VatsalSheth/Smart-Energy-Monitor/Bhishma_Slave.xlsx

Mouser Part Number | Description | Designator | Manufacturer_Part_Number | Quantity | Value | Mouser Price/Stock
81-GCM188R71C105K64D | Capacitor | C31, C111, C115, C116, C118, C209, C215 | GCM188R71C105KA64D | 7 | 1uF | https://www.mouser.com/Search/Refine.aspx?Keyword=81-GCM188R71C105K64D
81-GRM188C71E225KE1J | Capacitor | C32 | GRM188C71E225KE11J | 1 | 2.2uF | https://www.mouser.com/Search/Refine.aspx?Keyword=81-GRM188C71E225KE1J
581-06036D226MAT2A | Capacitor | C33 | 06036D226MAT2A | 1 | 22u | https://www.mouser.com/Search/Refine.aspx?Keyword=581-06036D226MAT2A
 | Capacitor | C101 | GRM1885C1H1R5CA01D | 1 | 1.5pF
81-GCG1885G1H101JA1D | Capacitor | C102 | GCG1885G1H101JA01D | 1 | 100pF | https://www.mouser.com/Search/Refine.aspx?Keyword=81-GCG1885G1H101JA1D
81-GCG1885G1H100JA1D | Capacitor | C103, C108 | GCG1885G1H100JA01D | 2 | 10pF | https://www.mouser.com/Search/Refine.aspx?Keyword=81-GCG1885G1H100JA1D
81-GCM188R71E224K55D | Capacitor | C106 | GCM188R71E224KA55D | 1 | 220nF | https://www.mouser.com/Search/Refine.aspx?Keyword=81-GCM188R71E224K55D
581-0603YC104JAT4A | Capacitor | C107, C119, C147, C148, C203, C205, C207, C210, C213, C216, C217, C218, C219, C220, C221 | 0603YC104JAT4A | 15 | 100nF | https://www.mouser.com/Search/Refine.aspx?Keyword=581-0603YC104JAT4A
81-GRM188R61E106KA3D | Capacitor | C110, C123, C149 | GRM188R61E106KA73D | 3 | 10 uF, 10uF, 10uF | https://www.mouser.com/Search/Refine.aspx?Keyword=81-GRM188R61E106KA3D
81-GCM1887U1H103JA6J | Capacitor | C113, C222 | GCM1887U1H103JA16J | 2 | 10nF | https://www.mouser.com/Search/Refine.aspx?Keyword=81-GCM1887U1H103JA6J
80-C0603C150F5GACTU | Capacitor | C201, C202 | C0603C150F5GACTU | 2 | 15pF | https://www.mouser.com/Search/Refine.aspx?Keyword=80-C0603C150F5GACTU
80-C0603C151J4G | Capacitor | C204, C206, C208, C211, C214 | C0603C151J4GACTU | 5 | 150pF | https://www.mouser.com/Search/Refine.aspx?Keyword=80-C0603C151J4G
81-GRM188R61C475KAJD | Capacitor | C212 | GRM188R61C475KAAJD | 1 | 4.7uF | https://www.mouser.com/Search/Refine.aspx?Keyword=81-GRM188R61C475KAJD
81-GRM1887U1A223JA1D | Capacitor | C223 | GRM1887U1A223JA01D | 1 | 22nF | https://www.mouser.com/Search/Refine.aspx?Keyword=81-GRM1887U1A223JA1D
595-TPD1E10B06DPYT | Single-Channel ESD in 0402 Package With 10pF Capacitance and 6V Breakdown 2-X1SON -40 to 125 | D31 | TPD1E10B06DPYT | 1 | TPD1E10B06DPYT
634-BGP632F512GM48D | Integrated Circuit | IC1 | EFR32BG13P632F512GM48-D | 1 |  | https://www.mouser.com/Search/Refine.aspx?Keyword=634-BGP632F512GM48D
584-LTC3550EDHC#PBF | Integrated Circuit | IC3 | LTC3550EDHC#PBF | 1 | LTC3550 | https://www.mouser.com/Search/Refine.aspx?Keyword=584-LTC3550EDHC%23PBF
511-STPM34TR | Integrated Circuit | IC5 | STPM34TR | 1 | STPM34TR | https://www.mouser.com/Search/Refine.aspx?Keyword=511-STPM34TR
512-FOD8012AR2 | Integrated Circuit | IC6 | FOD8012AR2 | 1 | FOD8012AR2 | https://www.mouser.com/Search/Refine.aspx?Keyword=512-FOD8012AR2
512-FOD8001 | Integrated Circuit | IC7, IC8 | FOD8001 | 2 | FOD8001 | https://www.mouser.com/Search/Refine.aspx?Keyword=512-FOD8001
490-UJ2-MIBH2-4-SMT | Micro B, USB 2.0, 1.8 A, Right Angle, Surface Mount _SMT_, USB Receptacle | J2 | UJ2-MIBH2-4-SMT-TR | 1 | UJ2-MIBH2-4-SMT-TR
710-691508110302 | 5081 Series 3.5mm Pitch Horizontal, PCBTerminal Block, Surface Mount, 2 Way | J3, J7, J8 | 691508110302 | 3
538-87898-1066 | Connector | J6, J103, J104, J105 | 87898-1066 | 3 |  | https://www.mouser.com/Search/Refine.aspx?Keyword=538-87898-0306
200-FTSH10501FDVK | Connector | J101 | FTSH-105-01-F-DV-K | 1 |  | https://www.mouser.com/Search/Refine.aspx?Keyword=200-FTSH10501FDVK
810-SLF6028T-4R7M | Inductor | L2 | SLF6028T-4R7M1R6-PF | 1 | 4.7uH | https://www.mouser.com/Search/Refine.aspx?Keyword=810-SLF6028T-4R7M
 | Inductor | L101, L102 | LQP03TQ1N9C02D | 2 | 1.9nH
810-KLZ1608MHR4R7WTD | Inductor | L103 | KLZ1608MHR4R7WTD25 | 1 | 4.7uH | https://www.mouser.com/Search/Refine.aspx?Keyword=810-KLZ1608MHR4R7WTD
81-BLM11A601S | Filter | L104, L105 | BLM18AG601SN1D | 2 |  | https://www.mouser.com/Search/Refine.aspx?Keyword=81-BLM11A601S
710-74279266 | Ferrite Bead | L106 | 74279266 | 1 | CBF102WB | https://www.mouser.com/Search/Refine.aspx?Keyword=710-74279266
630-HSMC-C190 | LED | LED2 | HSMC-C190 | 1 |  | https://www.mouser.com/Search/Refine.aspx?Keyword=630-HSMC-C190
798-U.FL-R-SMT-110 | Connector | P101 | U.FL-R-SMT-1(10) | 1 |  | https://www.mouser.com/Search/Refine.aspx?Keyword=798-U.FL-R-SMT-110
709-IRM03-3.3S | Power Supply | PS1 | IRM-03-3.3S | 1 | IRM-03-3.3S | https://www.mouser.com/Search/Refine.aspx?Keyword=709-IRM03-3.3S
594-MCT06030D2201BP1 | Resistor | R31, R34 | MCT06030D2201BP100 | 2 | 2.2K | https://www.mouser.com/Search/Refine.aspx?Keyword=594-MCT06030D2201BP1
667-ERA-3ARB112V | Resistor | R32 | ERA-3ARB112V | 1 | 1.1K | https://www.mouser.com/Search/Refine.aspx?Keyword=667-ERA-3ARB112V
594-MCT0603MD1001BP5 | Resistor | R33 | MCT0603MD1001BP500 | 1 | 1K | https://www.mouser.com/Search/Refine.aspx?Keyword=594-MCT0603MD1001BP5
71-TNPW12061M35BEEN | Res Thin Film 1206 1.35M Ohm 0.1% 0.25W_1/4W_ Â±25ppm/C Molded SMD Paper T/R | R35 | TNPW12061M35BEEN | 1 | 1.35M
667-ERA-3AEB3013V | Resistor | R36 | ERA-3AEB3013V | 1 | 301K | https://www.mouser.com/Search/Refine.aspx?Keyword=667-ERA-3AEB3013V
279-CRGS0603J1R0 | Resistor | R101 | CRGS0603J1R0 | 1 | 1 Ohm | https://www.mouser.com/Search/Refine.aspx?Keyword=279-CRGS0603J1R0
71-CRCW12060000Z0EAC | Resistor | R102, R104, R202 | CRCW12060000Z0EAC | 3 | 0R | https://www.mouser.com/Search/Refine.aspx?Keyword=71-CRCW12060000Z0EAC
594-MCT06030C1004FP5 | Resistor | R201 | MCT06030C1004FP500 | 1 | 1M | https://www.mouser.com/Search/Refine.aspx?Keyword=594-MCT06030C1004FP5
594-MCT0603MD1002BP5 | Resistor | R203, R204, R205, R206 | MCT0603MD1002BP500 | 4 | 10K | https://www.mouser.com/Search/Refine.aspx?Keyword=594-MCT0603MD1002BP5
594-MCT0603PD1001DP5 | Resistor | R207, R208 | MCT0603PD1001DP500 | 2 | 1K | https://www.mouser.com/Search/Refine.aspx?Keyword=594-MCT0603PD1001DP5
279-RP73D1J5R9BTDG | Resistor | R209 | RP73D1J5R9BTDG | 1 | 5R9 | https://www.mouser.com/ProductDetail/TE-Connectivity-Holsworthy/RP73D1J5R9BTDG
594-MCT06030C2703FP5 | Resistor | R210, R211, R212 | MCT06030C2703FP500 | 3 | 270K | https://www.mouser.com/Search/Refine.aspx?Keyword=594-MCT06030C2703FP5
667-ERA-3APB471V | Resistor | R213 | ERA-3APB471V | 1 | 470R | https://www.mouser.com/Search/Refine.aspx?Keyword=667-ERA-3APB471V
612-LL3301NF065QG | Switch | S101 | LL3301NF065QG | 1 |  | https://www.mouser.com/Search/Refine.aspx?Keyword=612-LL3301NF065QG
520-384-8-36Q-CKYT | Crystal or Oscillator | Y101 | ECS-384-8-36Q-CKY-TR | 1 | 38.4 MHz | https://www.mouser.com/ProductDetail/ECS/ECS-384-8-36Q-CKY-TR
520-.327-6-12R-T | Crystal or Oscillator | Y102 | ECS-.327-6-12R-TR | 1 | 32.768KHz | https://www.mouser.com/ProductDetail/ECS/ECS-327-6-12R-TR
520-160-8-36B-CKYT | Crystal or Oscillator | Y201 | ECS-160-8-36B-CKY-TR | 1 | 16MHz | https://www.mouser.com/Search/Refine.aspx?Keyword=520-160-8-36B-CKYT
5169-UBP563450 | Battery 3.7V 950 mAh |  | UBP002 | 2 | 3.7V 900mAh | https://www.mouser.com/ProductDetail/Ultralife/UBP002
