VatsalSheth/Smart-Energy-Monitor/Bhishma/BgBuild_Log.txt

// Copyright 2019 Silicon Laboratories, Inc.
//
//

Executing: bgbuild.exe (C:\SiliconLabs\SimplicityStudio\v4\developer\sdks\blemesh\v1.3\protocol\bluetooth\bin\bgbuild.exe)
Standard output
ALL OK
