VatsalSheth/Smart-Energy-Monitor/Bhishma_Slave.pdf

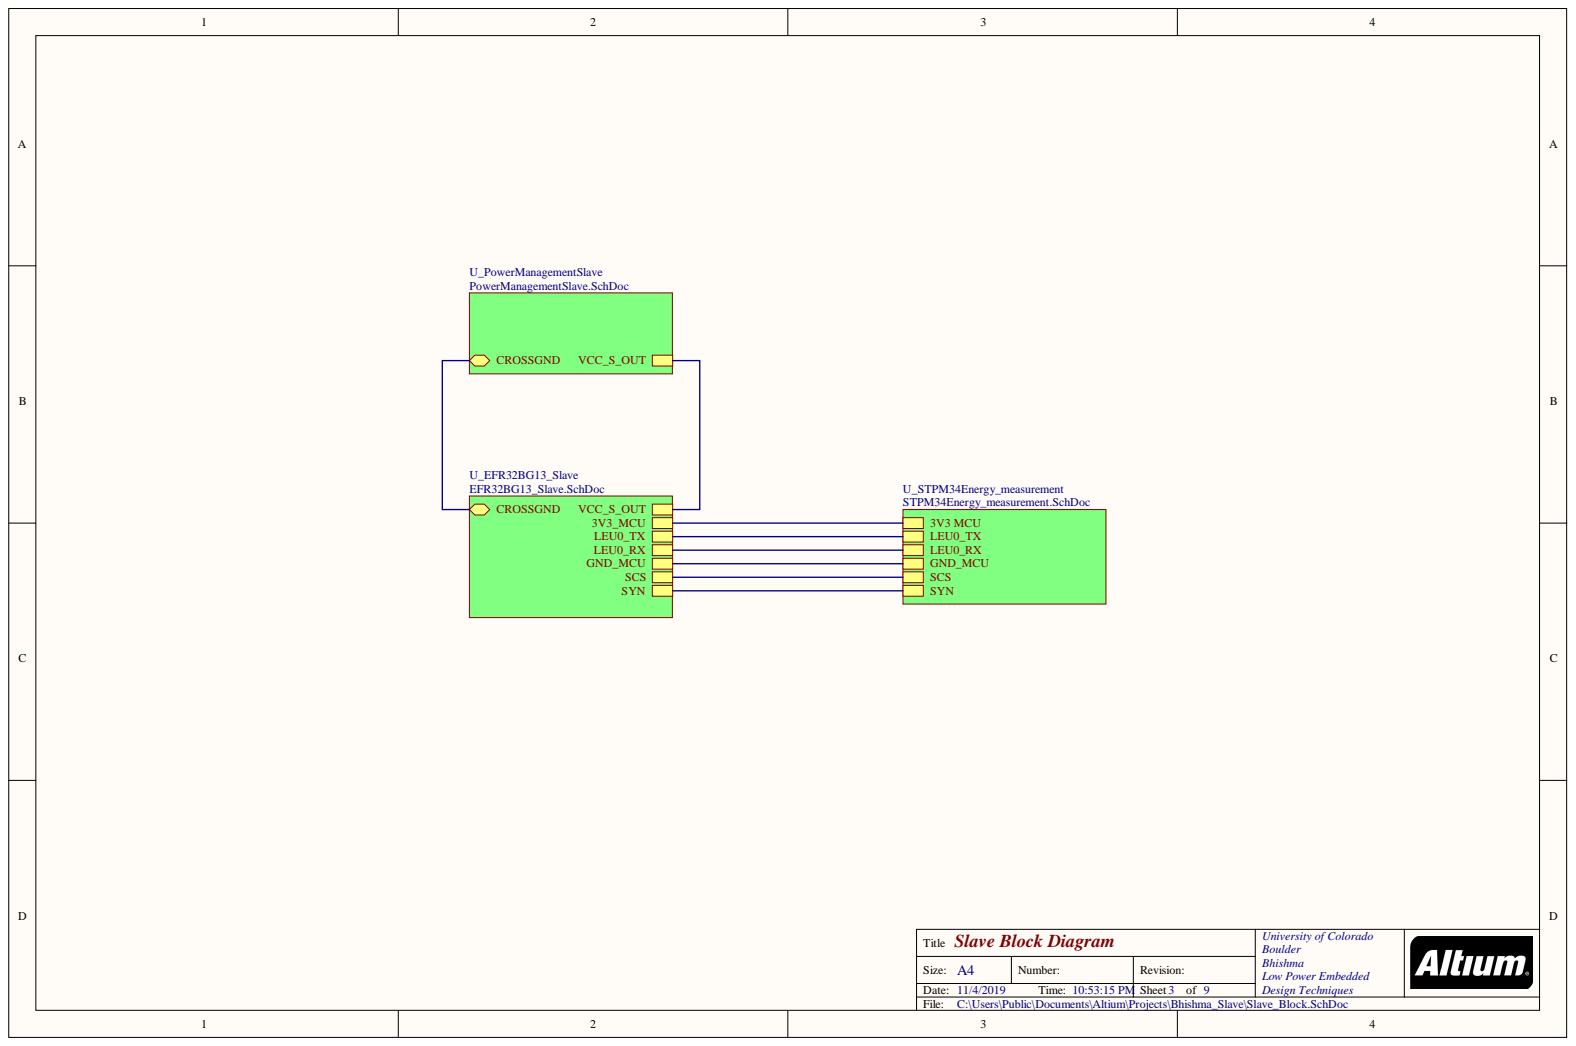
[picture p22: page 1]

Slave Block Diagram Title | University of Colorado Boulder Bhishma Low Power Embedded Design Techniques

A4 Size: | Number: | Revision:

Date: 11/4/2019 Time: 10:53:15 PM | | Sheet 3 of 9
File: C:\Users\Public\Documents\Altium\Projects\Bhishma_Slave\Slave_Block.SchDoc

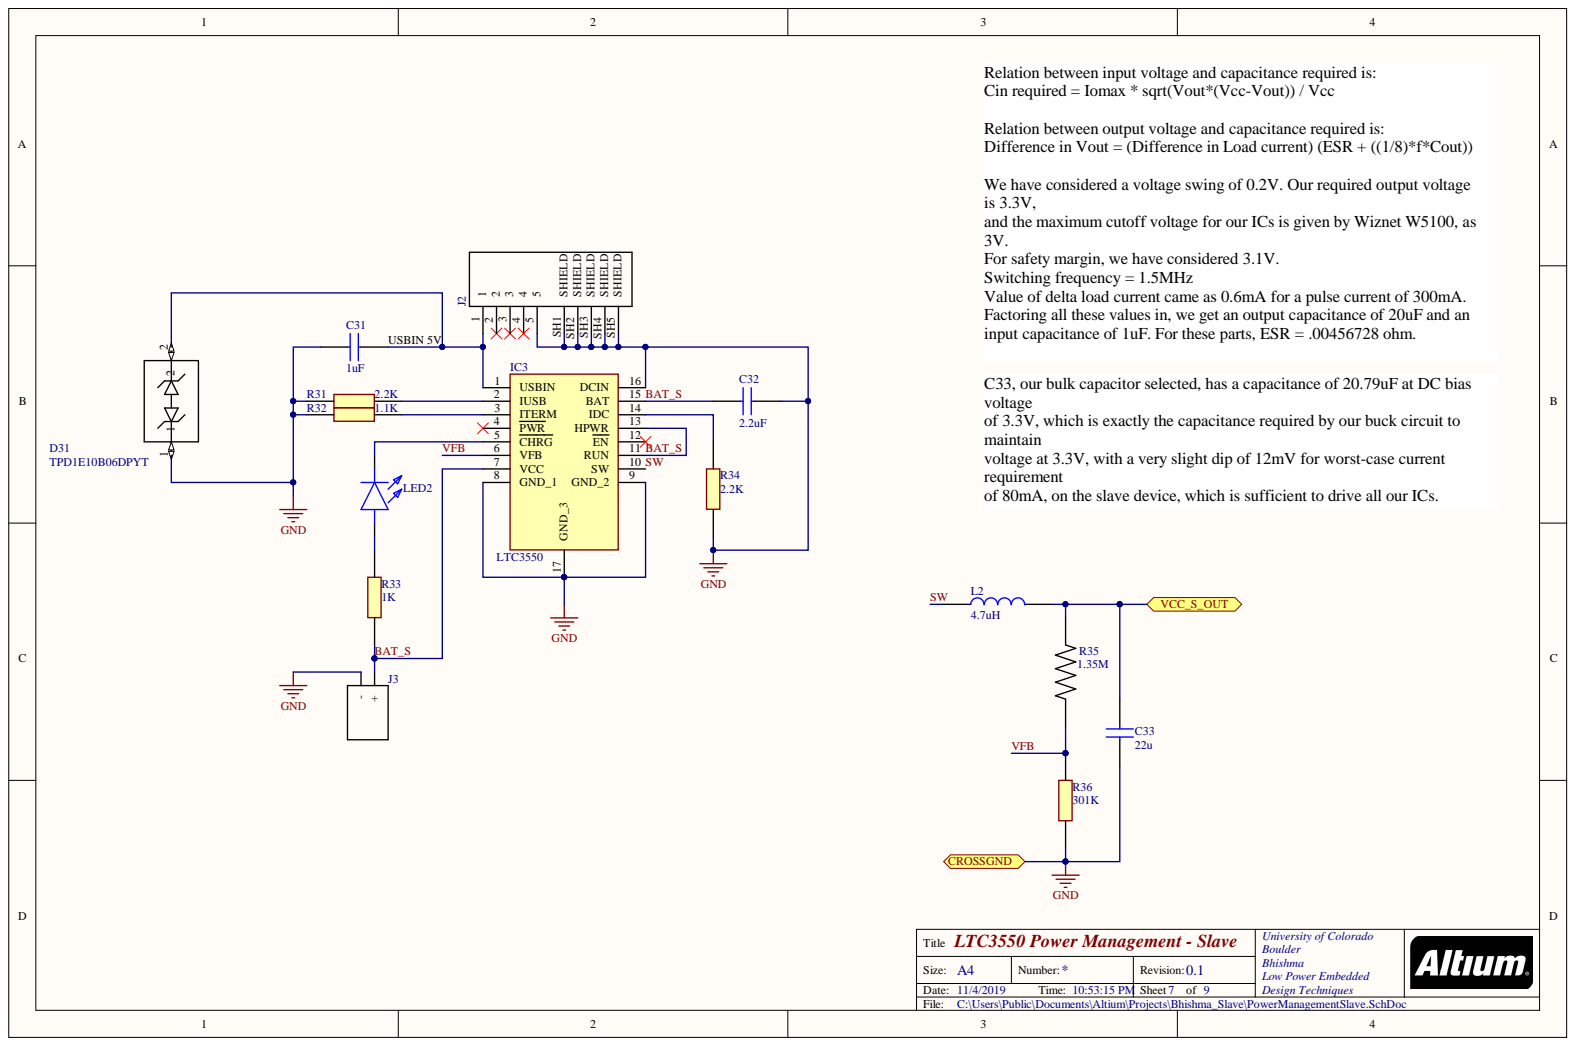
[picture p23: page 2]

ut*(Vcc-Vout)) / Vcc

e and capacitance required is:

nce in Load curre

ltage and capacitance required is:

and th
3V. For safety margin, we hav

ltage swing of 0.2V. Our required output v

ur ICs is giv

SHIELD SH5 SHIELD SH4 SHIELD SH3 SHIELD SH2 SHIELD SH1

e capacitance required by our buck circuit to

ery slight dip of 12mV for worst-case current

vice, which is su

fficient to drive al

T it l e | University of Colo rad o Boulder Bhishma Low Power Embedded Design Techniques

A4 S ize: | Number: | Rev isi o n :

11/4/2019 T i m e : 10:53:15 PM | | S heet 7 o f 9
C:\Users\Pub lic\Do c u men ts\A l t iu m\Projec ts\Bh ish ma_S lave\PowerManagemen tSlave.SchDo | c

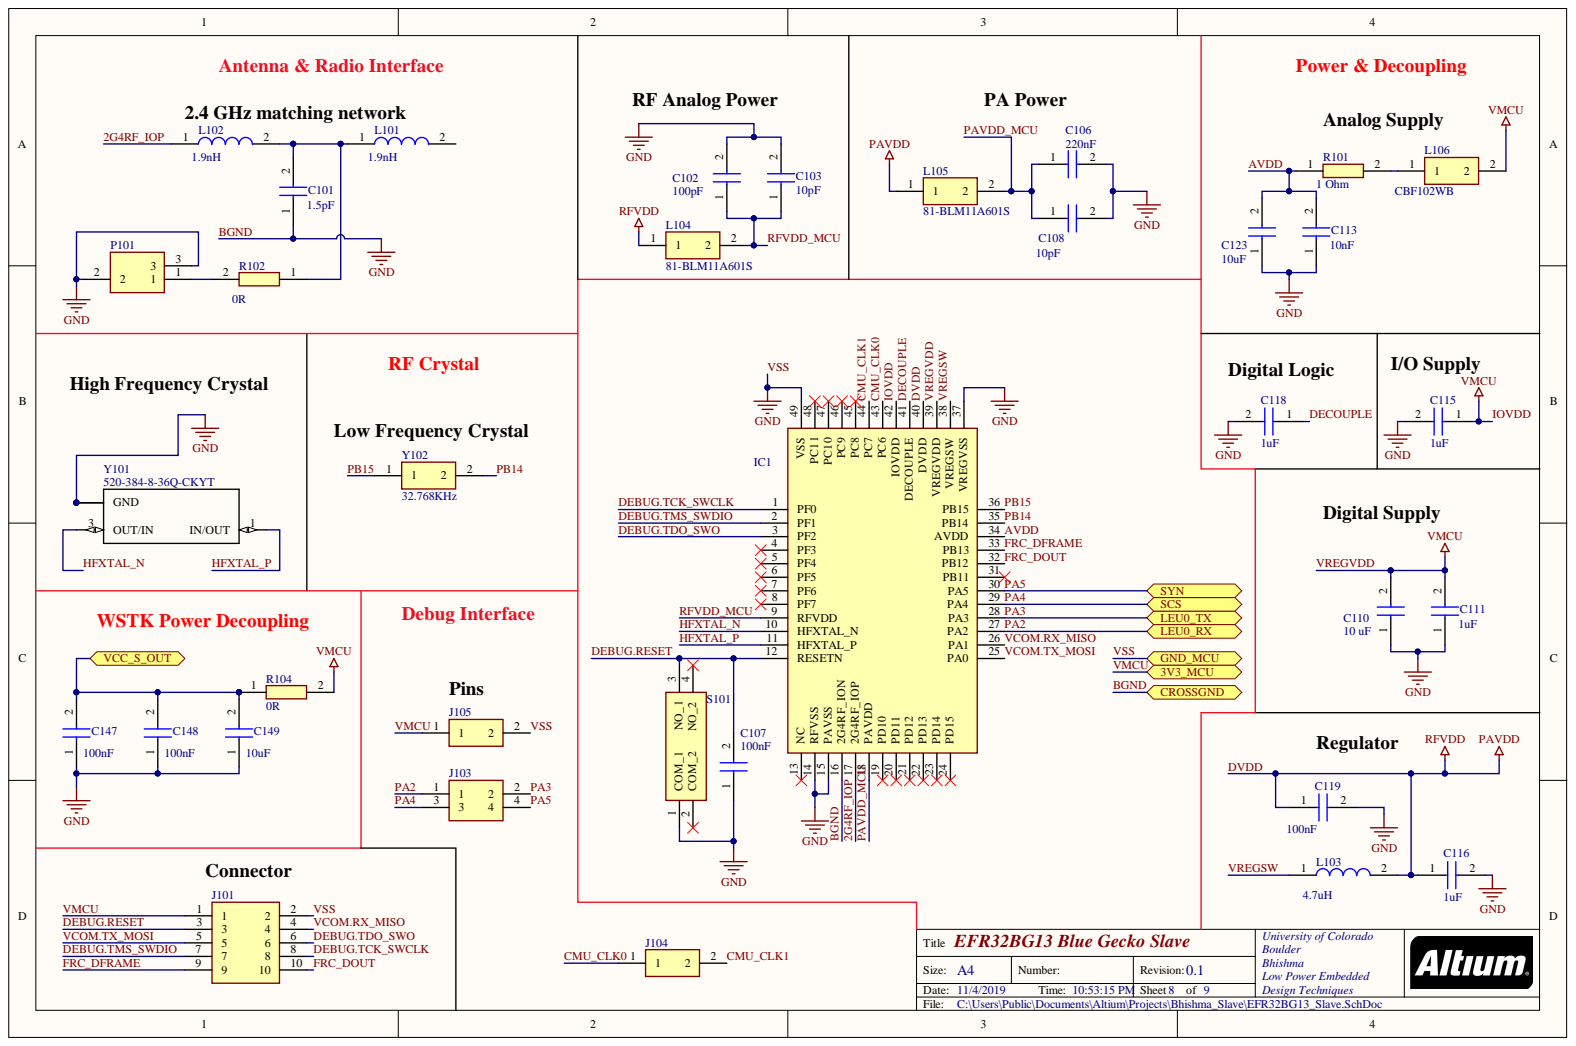
[picture p24: page 3]

C:\Users\Public\Documents\Altium\Projects\Bhishma_Slave\EFR32BG13_Slave.SchDoc

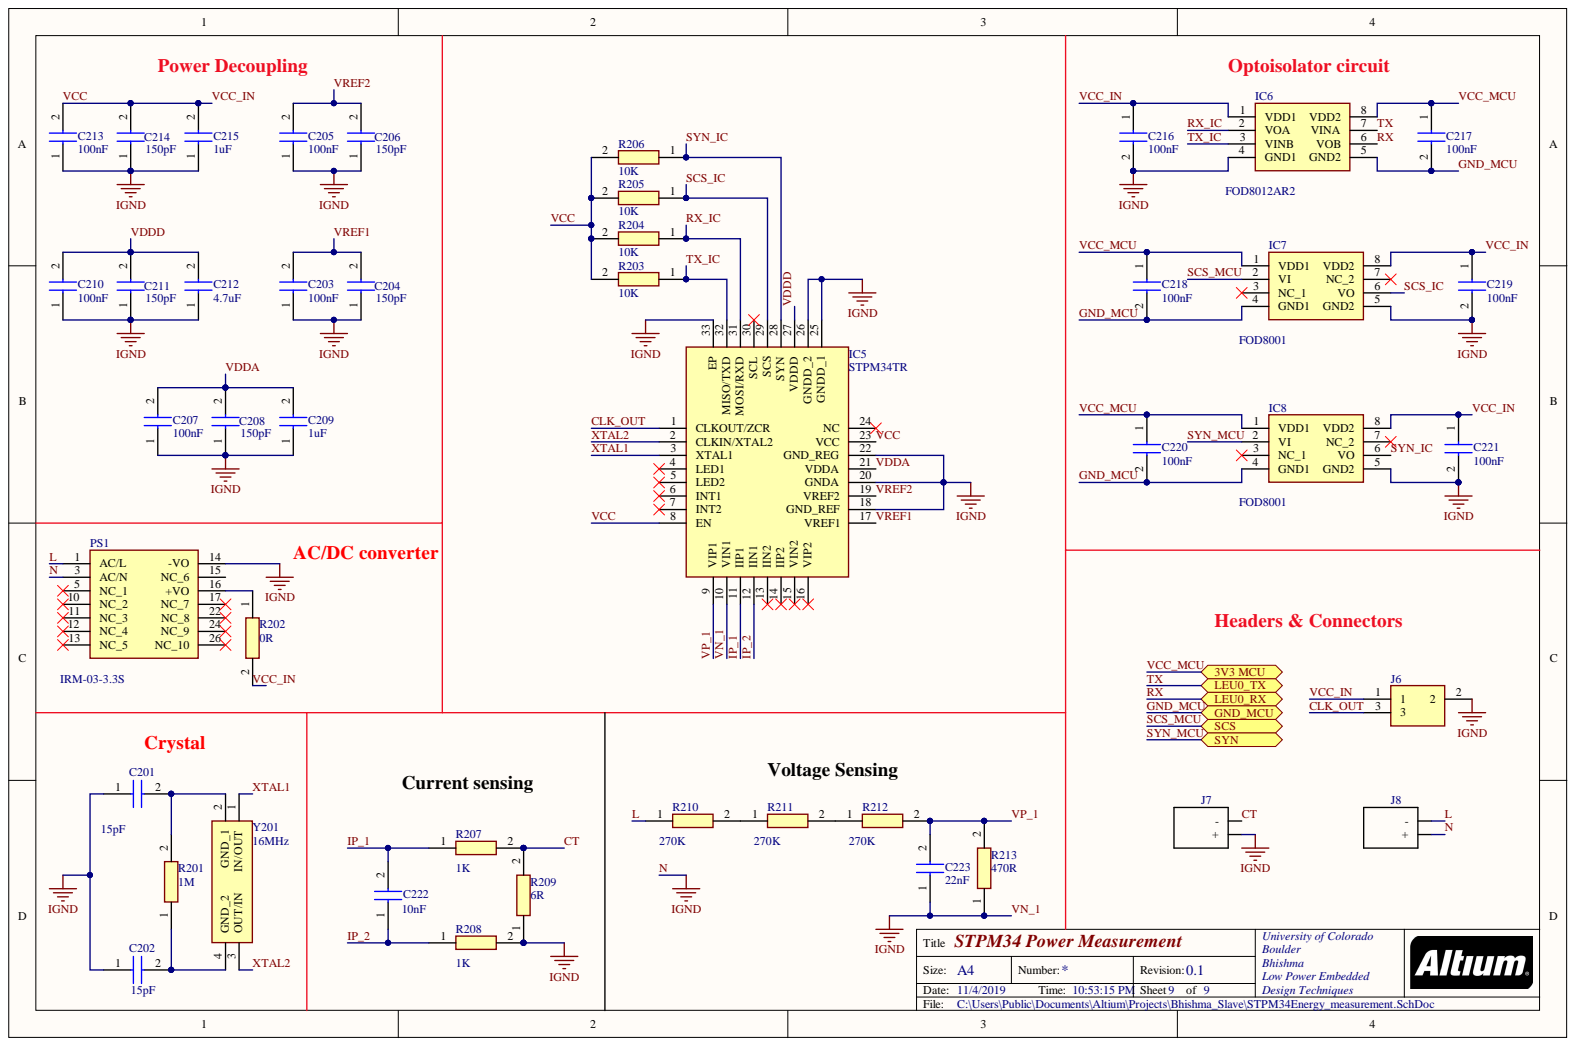
[picture p25: page 4]

STPM34 Power Measurement Title | University of Colorado Boulder Bhishma Low Power Embedded Design Techniques

A4 Size: | * Number: | 0.1 Revision:

Date: 11/4/2019 Time: 10:53:15 PM | | Sheet 9 of 9
File: C:\Users\Public\Documents\Altium\Projects\Bhishma_Slave\STPM34Energy_measurement.SchDoc

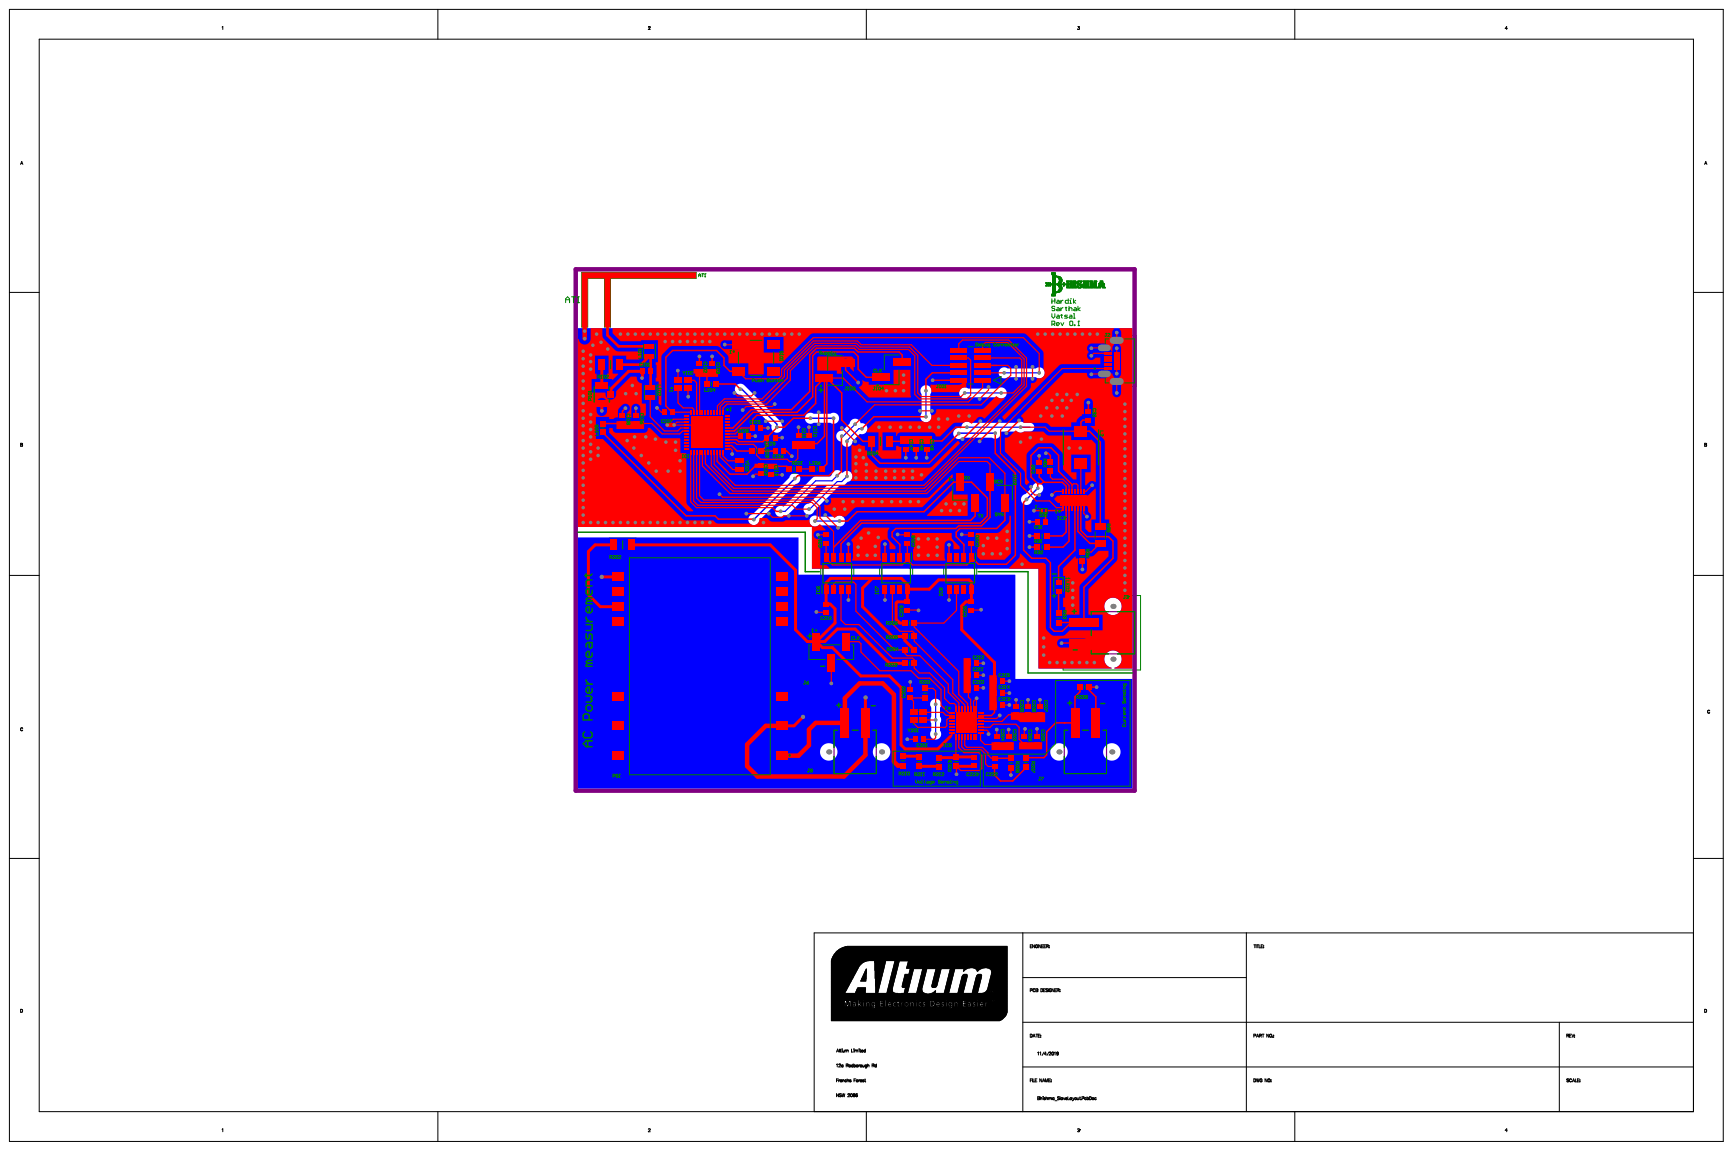
[picture p26: page 5]
