VatsalSheth/Smart-Energy-Monitor/(list of files, drawings)

Other design files:
Altium files/Bhishma_Slave/Bhishma_Slave.PrjPcb
Altium files/Bhishma_Slave/Bhishma_SlaveLayout.PcbDoc
Altium files/Bhishma_Slave/EFR32BG13_Slave.SchDoc
Altium files/Bhishma_Slave/PowerManagementSlave.SchDoc
Altium files/Bhishma_Slave/Slave_Block.SchDoc
Altium files/Bhishma_Slave/STPM34Energy_measurement.SchDoc
