VatsalSheth/Smart-Energy-Monitor/Bhishma/src/gpio.h

//***********************************************************************************
// Include files
//***********************************************************************************
#include "em_gpio.h"

//***********************************************************************************
// defined files
//***********************************************************************************

#define LFCLK_OUT_PORT	(gpioPortC)
#define LFCLK_OUT_PIN	(6)

#define HFCLK_OUT_PORT	(gpioPortC)
#define HFCLK_OUT_PIN	(7)

//***********************************************************************************
// global variables
//***********************************************************************************


//***********************************************************************************
// function prototypes
//***********************************************************************************
void gpio_init(void);
