VatsalSheth/Smart-Energy-Monitor/Bhishma/src/gpio.c

//***********************************************************************************
// Include files
//***********************************************************************************
#include "src/gpio.h"

//***********************************************************************************
// defined files
//***********************************************************************************


//***********************************************************************************
// global variables
//***********************************************************************************


//***********************************************************************************
// function prototypes
//***********************************************************************************


//***********************************************************************************
// functions
//***********************************************************************************
void gpio_init(void){

	GPIO_PinModeSet(LFCLK_OUT_PORT, LFCLK_OUT_PIN, gpioModePushPull, 0);
	GPIO_PinModeSet(HFCLK_OUT_PORT, HFCLK_OUT_PIN, gpioModePushPull, 0);
}
