VatsalSheth/Smart-Energy-Monitor/(commit log)

2019-10-20 Initial push of schematics v0.1
    [Bhishma.PrjPcb, EFR32BG13_Master.SchDoc, EFR32BG13_Slave.SchDoc, PowerManagementMaster.SchDoc, PowerManagementSlave.SchDoc, STPM34Energy_measurement.SchDoc, Symbols_schema.SchDoc, WizNet5100.SchDoc]
2019-10-20 Files deleted
    [Bhishma.PrjPcb, EFR32BG13_Master.SchDoc, EFR32BG13_Slave.SchDoc, PowerManagementMaster.SchDoc, PowerManagementSlave.SchDoc, STPM34Energy_measurement.SchDoc, Symbols_schema.SchDoc, WizNet5100.SchDoc]
2019-10-20 Smart pdf with BOM added
    [Bhishma.PrjPcb, Bhishma_BOM.xls, Block Diagram.SchDoc, EFR32BG13_Master.SchDoc, EFR32BG13_Slave.SchDoc, Master_Block.SchDoc, PowerManagementMaster.SchDoc, PowerManagementSlave.SchDoc]
2019-10-20 BOM attached outside
    [Bhishma_BOM.xls]
2019-10-27 Updated Power Management Circuit
    [Bhishma.PrjPcb, Bhishma_BOM.xls, Bhishma_Layout.PcbDoc, EFR32BG13_Master.SchDoc, Master_Block.SchDoc, PowerManagementMaster.SchDoc, PowerManagementSlave.SchDoc, STPM34Energy_measurement.SchDoc]
2019-10-29 Slave schematic pushed in place of rev.1
    [Bhishma.PrjPcb, Bhishma_BOM.xls, Bhishma_Layout.PcbDoc, Bhishma_Slave.PrjPcb, Bhishma_SlaveLayout.PcbDoc, Block Diagram.SchDoc, EFR32BG13_Master.SchDoc, EFR32BG13_Slave.SchDoc]
2019-10-29 Layout updated for STPM
    [Bhishma_SlaveLayout.PcbDoc, STPM34Energy_measurement.SchDoc]
2019-10-29 GND pour for STPM added
    [Bhishma_SlaveLayout.PcbDoc, EFR32BG13_Slave.SchDoc, STPM34Energy_measurement.SchDoc]
2019-10-29 STPM layout complete
    [Bhishma_SlaveLayout.PcbDoc]
2019-10-30 antenna layout
    [Bhishma_SlaveLayout.PcbDoc, EFR32BG13_Slave.SchDoc]
2019-10-30 net fixed
    [Bhishma_SlaveLayout.PcbDoc, EFR32BG13_Slave.SchDoc]
2019-10-30 Prelim commit
    [Bhishma_SlaveLayout.PcbDoc, EFR32BG13_Slave.SchDoc]
2019-10-31 Layout pseudo-complete
    [Bhishma_SlaveLayout.PcbDoc, EFR32BG13_Slave.SchDoc, PowerManagementSlave.SchDoc, Slave_Block.SchDoc]
2019-10-31 Layout complete v0.1
    [Bhishma_SlaveLayout.PcbDoc]
2019-10-31 Layout complete v0.2
    [Bhishma_SlaveLayout.PcbDoc]
2019-11-02 Layout pours complete
    [Bhishma_Slave.PrjPcb, Bhishma_SlaveLayout.PcbDoc, PowerManagementSlave.SchDoc]
2019-11-04 Layout revisions made
    [Bhishma_Slave.PrjPcb, Bhishma_Slave.xlsx, Bhishma_SlaveLayout.PcbDoc, EFR32BG13_Slave.SchDoc]
2019-11-05 Layout review #2 changed made
    [Bhishma_BOM.xls, Bhishma_Slave.xlsx, Bhishma_SlaveLayout.PcbDoc]
2019-11-06 Changes suggested by Prof. made
    [Bhishma_SlaveLayout.PcbDoc]
