VatsalSheth/Smart-Energy-Monitor/(notices)

Notices in the files:
Bhishma_master/ioLibrary_Driver/Ethernet/wizchip_conf.h:
Copyright (c) 2013, WIZnet Co., LTD.
All rights reserved.
